RoboSAX/eagle_spielfeld/README.md

# eagle_spielfeld
Masterplatine des Spielfeldes
