RoboSAX/eagle_spielfeld/export/images/circuit.png

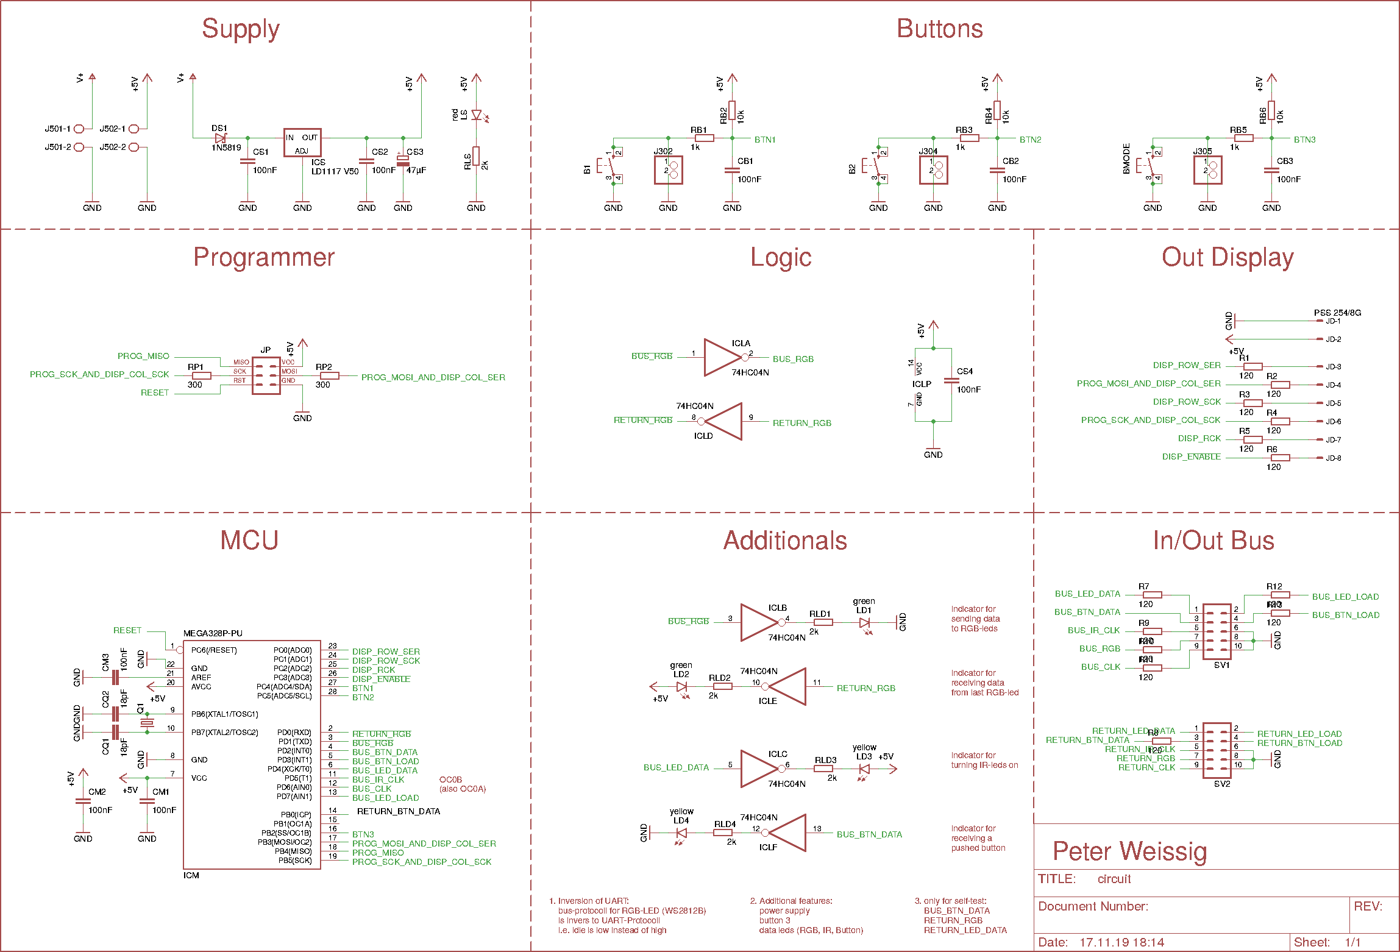
export/images/circuit.png
