RoboSAX/eagle_spielfeld/export/images/layout_bottom.png

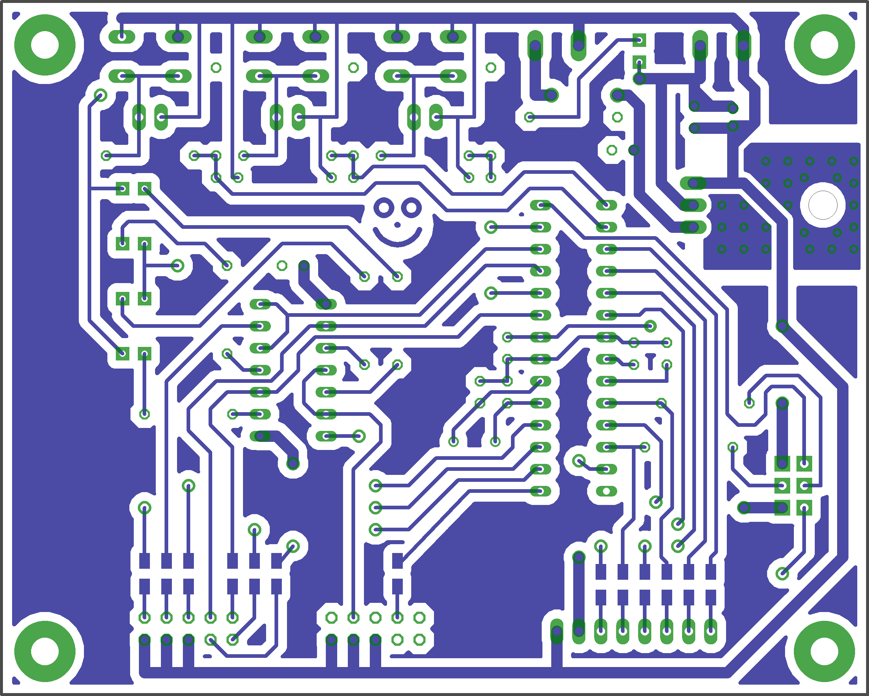
export/images/layout_bottom.png
