RoboSAX/eagle_spielfeld/export/images/layout_top.png

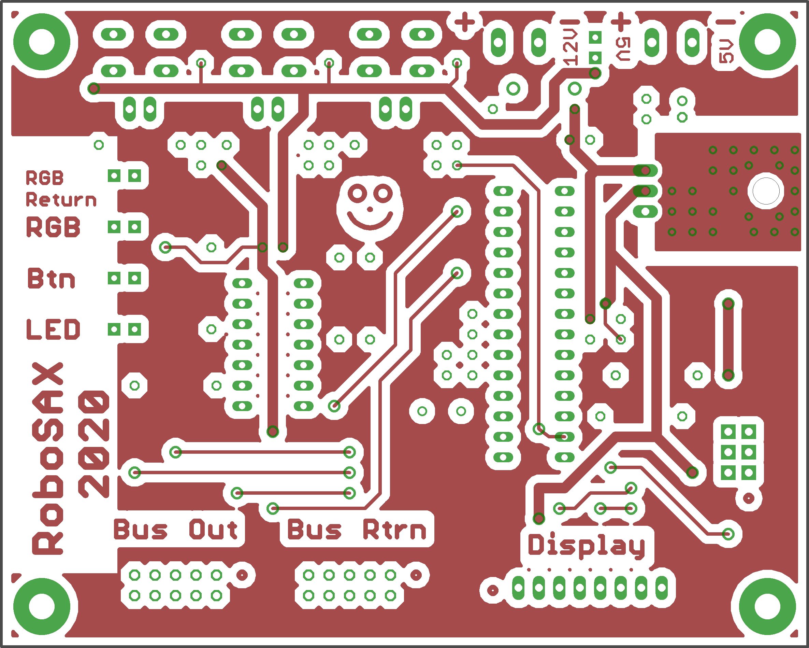
export/images/layout_top.png
