RoboSAX/eagle_spielfeld/parts/parts.pdf

## RoboSAX_spielfeld_tht

das RoboSAX OrgaTeam (PW, MG) | Seite 1 von 2 | 17.11.2019
Name | Value / Description | Order code | # | Prize | Sum
B1, B2, BMODE | button; 6x6mm; h=5mm | 3 | 0,14 € | 0,42 €
CQ1, CQ2 | 18pF; 2,5mm | 2 | 0,05 € | 0,10 €
100nF; 2,5mm | 9 | 0,07 € | 0,63 €
CS3 | 47µF; 2mm; d=5mm | 1 | 0,03 € | 0,03 €
DS1 | low drop | 1 | 0,06 € | 0,06 €
ICL | 6x logic inverter | 1 | 0,35 € | 0,35 €
ICM | atmega 328P | 1 | 2,25 € | 2,25 €
ICS | low-drop; 5V; 1A | 1 | 0,51 € | 0,51 €
J302, J304, J305 | special pin head; 1x2 pins | 3 | 0,05 € | 0,15 €
JD | special pin head; 1x8 pins | 1 | 0,08 € | 0,08 €
JP | box header; 2x3 pins | 1 | 0,20 € | 0,20 €
SV1, SV2 | box header; 2x5 pins | 2 | 0,10 € | 0,20 €
J501, J502 | connecting teminal; 2x | 2 | 0,32 € | 0,64 €
LD1, LD2 | 3mm; 2mA; green | 2 | 0,12 € | 0,24 €
LD3, LD4 | 3mm; 2mA, yellow | 2 | 0,12 € | 0,24 €
LS | 3mm; 2mA, red | 1 | 0,12 € | 0,12 €
Q1 | crystal; 20 MHz | 1 | 0,22 € | 0,22 €
R1, R2, R3, … R13 | 120 | 13 | 0,02 € | 0,26 €
RP1, RP2 | 300 | 2 | 0,08 € | 0,16 €
RB1, RB3, RB5 | 1k | 3 | 0,08 € | 0,24 €
RLD1, RLD2, RLD3, RLD4, RLS | 2k | 5 | 0,08 € | 0,40 €
RB2, RB4, RB6 | 10k | 3 | 0,08 € | 0,24 €

7,74 €

TASTER 9302 (https://www.reichelt.de/kurzhubtaster-6x6mm-hoehe-5-0mm-12v-vertikal-taster-9302-p44579.html)
KERKO 18P (https://www.reichelt.de/keramik-kondensator-18p-kerko-18p-p9274.html)
CB1, CB2, CB3,
CM1, CM2, CM3,
CS1, CS2, CS4

X7R-2,5 100N (https://www.reichelt.de/vielschicht-keramikkondensator-100n-10-x7r-2-5-100n-p22853.html)

RAD 105 47/35 (https://www.reichelt.de/elko-radial-47-f-35-v-rm-2-5-1000h-105-c-20-rad-105-47-35-p42399.html)
1N 5819 (https://www.reichelt.de/schottkydiode-40-v-1-a-do-41-1n-5819-p41850.html)
74HC 04 (https://www.reichelt.de/inverter-hex-2-6-v-dil-14-74hc-04-p3123.html)
ATMEGA 328P-PU (https://www.reichelt.de/mcu-atmega-avr-risc-32-kb-20-mhz-pdip-28-atmega-328p-pu-p119685.html)
LD1117 V50 (https://www.reichelt.de/ldo-regler-fest-5-v-to-220-ld1117-v50-p200893.html)
PSS 254/2G (https://www.reichelt.de/printstecker-einzelstecker-gerade-2-polig-pss-254-2g-p14907.html)
PSS 254/8G (https://www.reichelt.de/printstecker-einzelstecker-gerade-8-polig-pss-254-8g-p14913.html)
WSL 6G (https://www.reichelt.de/wannenstecker-6-polig-gerade-wsl-6g-p85732.html)
WSL 10G (https://www.reichelt.de/wannenstecker-10-polig-gerade-wsl-10g-p22816.html)
AKL 101-02 (https://www.reichelt.de/anschlussklemme-2-pol-2-mm-rm-5-08-akl-101-02-p36605.html)
LED 3MM 2MA GN (https://www.reichelt.de/led-3-mm-bedrahtet-gruen-3-2-mcd-60-led-3mm-2ma-gn-p21624.html)
LED 3MM 2MA GE (https://www.reichelt.de/led-3-mm-bedrahtet-gelb-3-2-mcd-60-led-3mm-2ma-ge-p21628.html)
LED 3MM 2MA RT (https://www.reichelt.de/led-3-mm-bedrahtet-rot-5-mcd-60-led-3mm-2ma-rt-p21626.html)
20,0000-HC49U-S (https://www.reichelt.de/standardquarz-grundton-20-000000-mhz-20-0000-hc49u-s-p32853.html)
RND 1206 1 120 (https://www.reichelt.de/smd-widerstand-1206-120-ohm-250-mw-1-rnd-1206-1-120-p183350.html)
METALL 300 (https://www.reichelt.de/widerstand-metallschicht-300-ohm-0207-0-6-w-1-metall-300-p11715.html)
METALL 1,00K (https://www.reichelt.de/widerstand-metallschicht-1-00-kohm-0207-0-6-w-1-metall-1-00k-p11403.html)
METALL 2,00K (https://www.reichelt.de/widerstand-metallschicht-2-00-kohm-0207-0-6-w-1-metall-2-00k-p11578.html)
METALL 10,0K (https://www.reichelt.de/widerstand-metallschicht-10-0-kohm-0207-0-6-w-1-metall-10-0k-p11449.html)
Shopping cart (also some additional parts): | https://www.reichelt.de/my/1638795

## Additionals

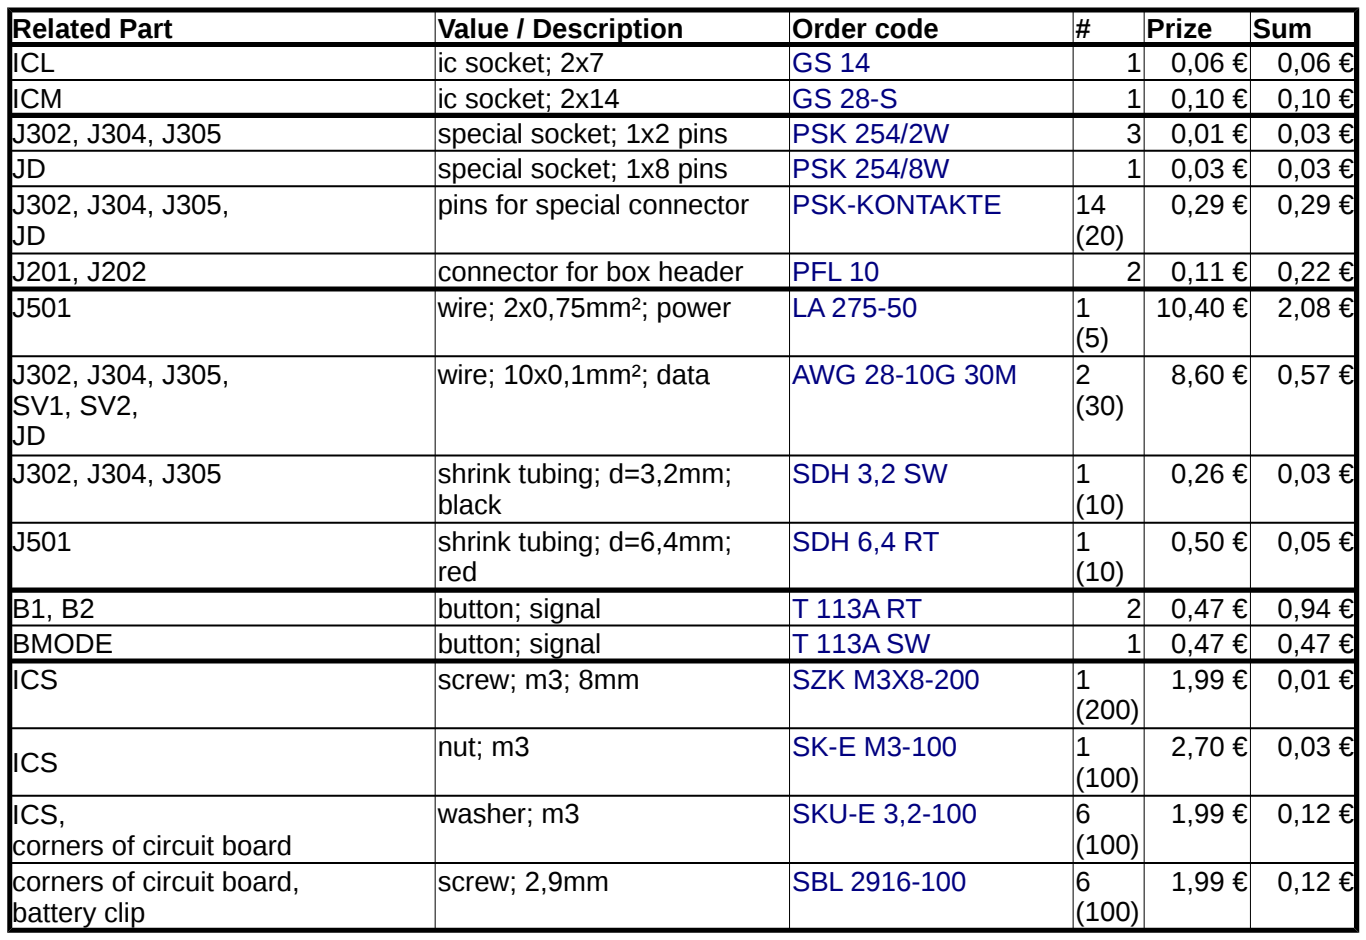
[picture p4: figure]
Related Part; Value / Description; Order code; Prize; Sum; ICL; ic socket; 2x7; ICM; ic socket; 2x14; special socket; 1x2 pins; special socket; 1x8 pins; pins for special connector; connector for box header; wire; 2x0,75mm²; power; wire; 10x0,1mm²; data; button; signal; BMODE; ICS; screw; m3; 8mm; nut; m3; washer; m3; screw; 2,9mm; GS 14 GS 28-S PSK 254/2W PSK 254/8W; PSK-KONTAKTE; PFL 10; AWG 28-10G 30M; shrink tubing; d=3,2mm; black; SDH 3,2 SW; shrink tubing; d=6,4mm; red; SDH 6,4 RT; SZK M3X8-200; ICS, corners of circuit board; SKU-E 3,2-100; corners of circuit board, battery clip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

das RoboSAX OrgaTeam (PW, MG) | Seite 2 von 2 | 17.11.2019

5,15 €

Shopping cart (some additional and all main parts): https://www.reichelt.de/my/1638795
