RoboSAX/eagle_spielfeld/parts/parts.ods

Sheet: RoboSAX_spielfeld_tht
Name | Value / Description | Order code | # | Prize | Sum
B1, B2, BMODE | button; 6x6mm; h=5mm | TASTER 9302 (https://www.reichelt.de/kurzhubtaster-6x6mm-hoehe-5-0mm-12v-vertikal-taster-9302-p44579.html) | 3 | 0,14 € | 0,42 €
CQ1, CQ2 | 18pF; 2,5mm | KERKO 18P (https://www.reichelt.de/keramik-kondensator-18p-kerko-18p-p9274.html) | 2 | 0,05 € | 0,10 €
CB1, CB2, CB3, CM1, CM2, CM3, CS1, CS2, CS4 | 100nF; 2,5mm | X7R-2,5 100N (https://www.reichelt.de/vielschicht-keramikkondensator-100n-10-x7r-2-5-100n-p22853.html) | 9 | 0,07 € | 0,63 €
CS3 | 47µF; 2mm; d=5mm | RAD 105 47/35 (https://www.reichelt.de/elko-radial-47-f-35-v-rm-2-5-1000h-105-c-20-rad-105-47-35-p42399.html) | 1 | 0,03 € | 0,03 €
DS1 | low drop | 1N 5819 (https://www.reichelt.de/schottkydiode-40-v-1-a-do-41-1n-5819-p41850.html) | 1 | 0,06 € | 0,06 €
ICL | 6x logic inverter | 74HC 04 (https://www.reichelt.de/inverter-hex-2-6-v-dil-14-74hc-04-p3123.html) | 1 | 0,35 € | 0,35 €
ICM | atmega 328P | ATMEGA 328P-PU (https://www.reichelt.de/mcu-atmega-avr-risc-32-kb-20-mhz-pdip-28-atmega-328p-pu-p119685.html) | 1 | 2,25 € | 2,25 €
ICS | low-drop; 5V; 1A | LD1117 V50 (https://www.reichelt.de/ldo-regler-fest-5-v-to-220-ld1117-v50-p200893.html) | 1 | 0,51 € | 0,51 €
J302, J304, J305 | special pin head; 1x2 pins | PSS 254/2G (https://www.reichelt.de/printstecker-einzelstecker-gerade-2-polig-pss-254-2g-p14907.html) | 3 | 0,05 € | 0,15 €
JD | special pin head; 1x8 pins | PSS 254/8G (https://www.reichelt.de/printstecker-einzelstecker-gerade-8-polig-pss-254-8g-p14913.html) | 1 | 0,08 € | 0,08 €
JP | box header; 2x3 pins | WSL 6G (https://www.reichelt.de/wannenstecker-6-polig-gerade-wsl-6g-p85732.html) | 1 | 0,20 € | 0,20 €
SV1, SV2 | box header; 2x5 pins | WSL 10G (https://www.reichelt.de/wannenstecker-10-polig-gerade-wsl-10g-p22816.html) | 2 | 0,10 € | 0,20 €
J501, J502 | connecting teminal; 2x | AKL 101-02 (https://www.reichelt.de/anschlussklemme-2-pol-2-mm-rm-5-08-akl-101-02-p36605.html) | 2 | 0,32 € | 0,64 €
LD1, LD2 | 3mm; 2mA; green | LED 3MM 2MA GN (https://www.reichelt.de/led-3-mm-bedrahtet-gruen-3-2-mcd-60-led-3mm-2ma-gn-p21624.html) | 2 | 0,12 € | 0,24 €
LD3, LD4 | 3mm; 2mA, yellow | LED 3MM 2MA GE (https://www.reichelt.de/led-3-mm-bedrahtet-gelb-3-2-mcd-60-led-3mm-2ma-ge-p21628.html) | 2 | 0,12 € | 0,24 €
LS | 3mm; 2mA, red | LED 3MM 2MA RT (https://www.reichelt.de/led-3-mm-bedrahtet-rot-5-mcd-60-led-3mm-2ma-rt-p21626.html) | 1 | 0,12 € | 0,12 €
Q1 | crystal; 20 MHz | 20,0000-HC49U-S (https://www.reichelt.de/standardquarz-grundton-20-000000-mhz-20-0000-hc49u-s-p32853.html) | 1 | 0,22 € | 0,22 €
R1, R2, R3, … R13 | 120 | RND 1206 1 120 (https://www.reichelt.de/smd-widerstand-1206-120-ohm-250-mw-1-rnd-1206-1-120-p183350.html) | 13 | 0,02 € | 0,26 €
RP1, RP2 | 300 | METALL 300 (https://www.reichelt.de/widerstand-metallschicht-300-ohm-0207-0-6-w-1-metall-300-p11715.html) | 2 | 0,08 € | 0,16 €
RB1, RB3, RB5 | 1k | METALL 1,00K (https://www.reichelt.de/widerstand-metallschicht-1-00-kohm-0207-0-6-w-1-metall-1-00k-p11403.html) | 3 | 0,08 € | 0,24 €
RLD1, RLD2, RLD3, RLD4, RLS | 2k | METALL 2,00K (https://www.reichelt.de/widerstand-metallschicht-2-00-kohm-0207-0-6-w-1-metall-2-00k-p11578.html) | 5 | 0,08 € | 0,40 €
RB2, RB4, RB6 | 10k | METALL 10,0K (https://www.reichelt.de/widerstand-metallschicht-10-0-kohm-0207-0-6-w-1-metall-10-0k-p11449.html) | 3 | 0,08 € | 0,24 €
 |  |  | 7,74 €
Shopping cart (also some additional parts): |  |  | https://www.reichelt.de/my/1638795

Sheet: Additionals
Related Part | Value / Description | Order code | # | Prize | Sum
ICL | ic socket; 2x7 | GS 14 (https://www.reichelt.de/ic-sockel-14-polig-doppelter-federkontakt-gs-14-p8206.html) | 1 | 0,06 € | 0,06 €
ICM | ic socket; 2x14 | GS 28-S (https://www.reichelt.de/ic-sockel-28-polig-doppelter-federkontakt-gs-28-s-p86281.html) | 1 | 0,10 € | 0,10 €
J302, J304, J305 | special socket; 1x2 pins | PSK 254/2W (https://www.reichelt.de/kupplungs-leergehaeuse-crimptechnik-2-polig-psk-254-2w-p14857.html) | 3 | 0,01 € | 0,03 €
JD | special socket; 1x8 pins | PSK 254/8W (https://www.reichelt.de/kupplungs-leergehaeuse-crimptechnik-8-polig-psk-254-8w-p14860.html) | 1 | 0,03 € | 0,03 €
J302, J304, J305, JD | pins for special connector | PSK-KONTAKTE (https://www.reichelt.de/crimpkontakte-fuer-psk-254-20-stueck-psk-kontakte-p14861.html) | 14 (20) | 0,29 € | 0,29 €
J201, J202 | connector for box header | PFL 10 (https://www.reichelt.de/pfostenbuchse-10-polig-mit-zugentlastung-pfl-10-p14571.html) | 2 | 0,11 € | 0,22 €
J501 | wire; 2x0,75mm²; power | LA 275-50 (https://www.reichelt.de/zwillingslitze-flexibel-2x0-75mm-50m-ring-la-275-50-p36246.html) | 1 (5) | 10,40 € | 2,08 €
J302, J304, J305, SV1, SV2, JD | wire; 10x0,1mm²; data | AWG 28-10G 30M (https://www.reichelt.de/flachbandkabel-awg28-10-pol-grau-30m-rolle-awg-28-10g-30m-p47622.html) | 2 (30) | 8,60 € | 0,57 €
J302, J304, J305 | shrink tubing; d=3,2mm; black | SDH 3,2 SW (https://www.reichelt.de/10er-pack-2-1-schrumpfschlauch-3-2mm-schwarz-sdh-3-2-sw-p17406.html) | 1 (10) | 0,26 € | 0,03 €
J501 | shrink tubing; d=6,4mm; red | SDH 6,4 RT (https://www.reichelt.de/10er-pack-2-1-schrumpfschlauch-6-4mm-rot-sdh-6-4-rt-p17413.html) | 1 (10) | 0,50 € | 0,05 €
B1, B2 | button; signal | T 113A RT (https://www.reichelt.de/miniatur-drucktaster-0-5a-24vac-1x-ein-rt-t-113a-rt-p45166.html) | 2 | 0,47 € | 0,94 €
BMODE | button; signal | T 113A SW (https://www.reichelt.de/miniatur-drucktaster-0-5a-24vac-1x-ein-sw-t-113a-sw-p45167.html) | 1 | 0,47 € | 0,47 €
ICS | screw; m3; 8mm | SZK M3X8-200 (https://www.reichelt.de/zylinderkopfschrauben-schlitz-m3-8-mm-szk-m3x8-200-p65693.html) | 1 (200) | 1,99 € | 0,01 €
ICS | nut; m3 | SK-E M3-100 (https://www.reichelt.de/sechskantmuttern-edelstahl-a2-m3-sk-e-m3-100-p72592.html) | 1 (100) | 2,70 € | 0,03 €
ICS, corners of circuit board | washer; m3 | SKU-E 3,2-100 (https://www.reichelt.de/unterlegscheiben-edelstahl-a2-3-2-mm-sku-e-3-2-100-p72588.html) | 6 (100) | 1,99 € | 0,12 €
corners of circuit board, battery clip | screw; 2,9mm | SBL 2916-100 (https://www.reichelt.de/blechschrauben-pan-head-pzd-2-9-x-16-mm-sbl-2916-100-p130327.html) | 6 (100) | 1,99 € | 0,12 €
 |  |  | 5,15 €
Shopping cart (some additional and all main parts): |  |  | https://www.reichelt.de/my/1638795
