RoboSAX/eagle_spielfeld/export/images/parts_bottom.png

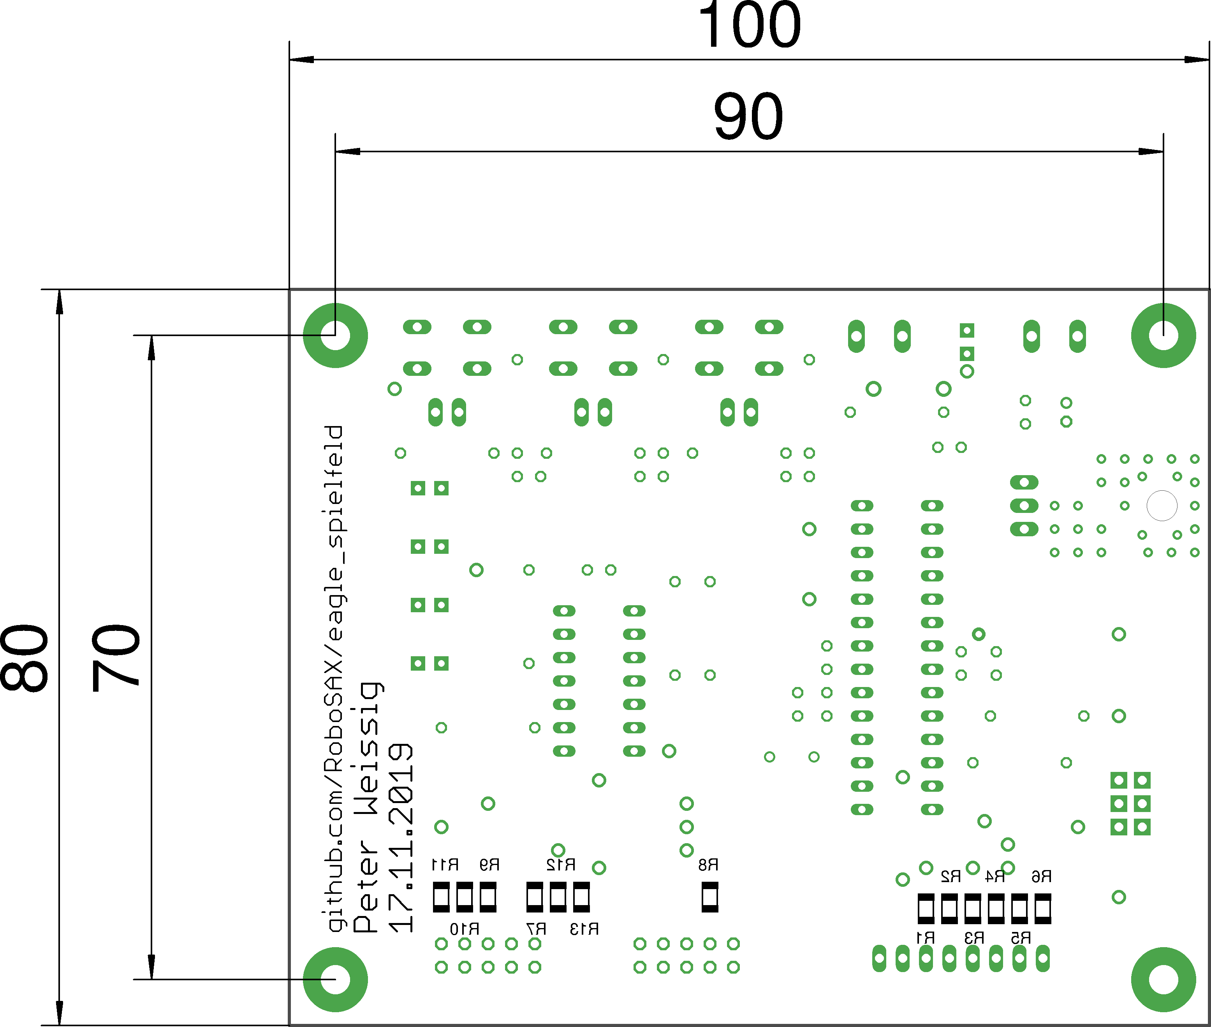
export/images/parts_bottom.png
