RoboSAX/eagle_spielfeld/export/images/parts_top.png

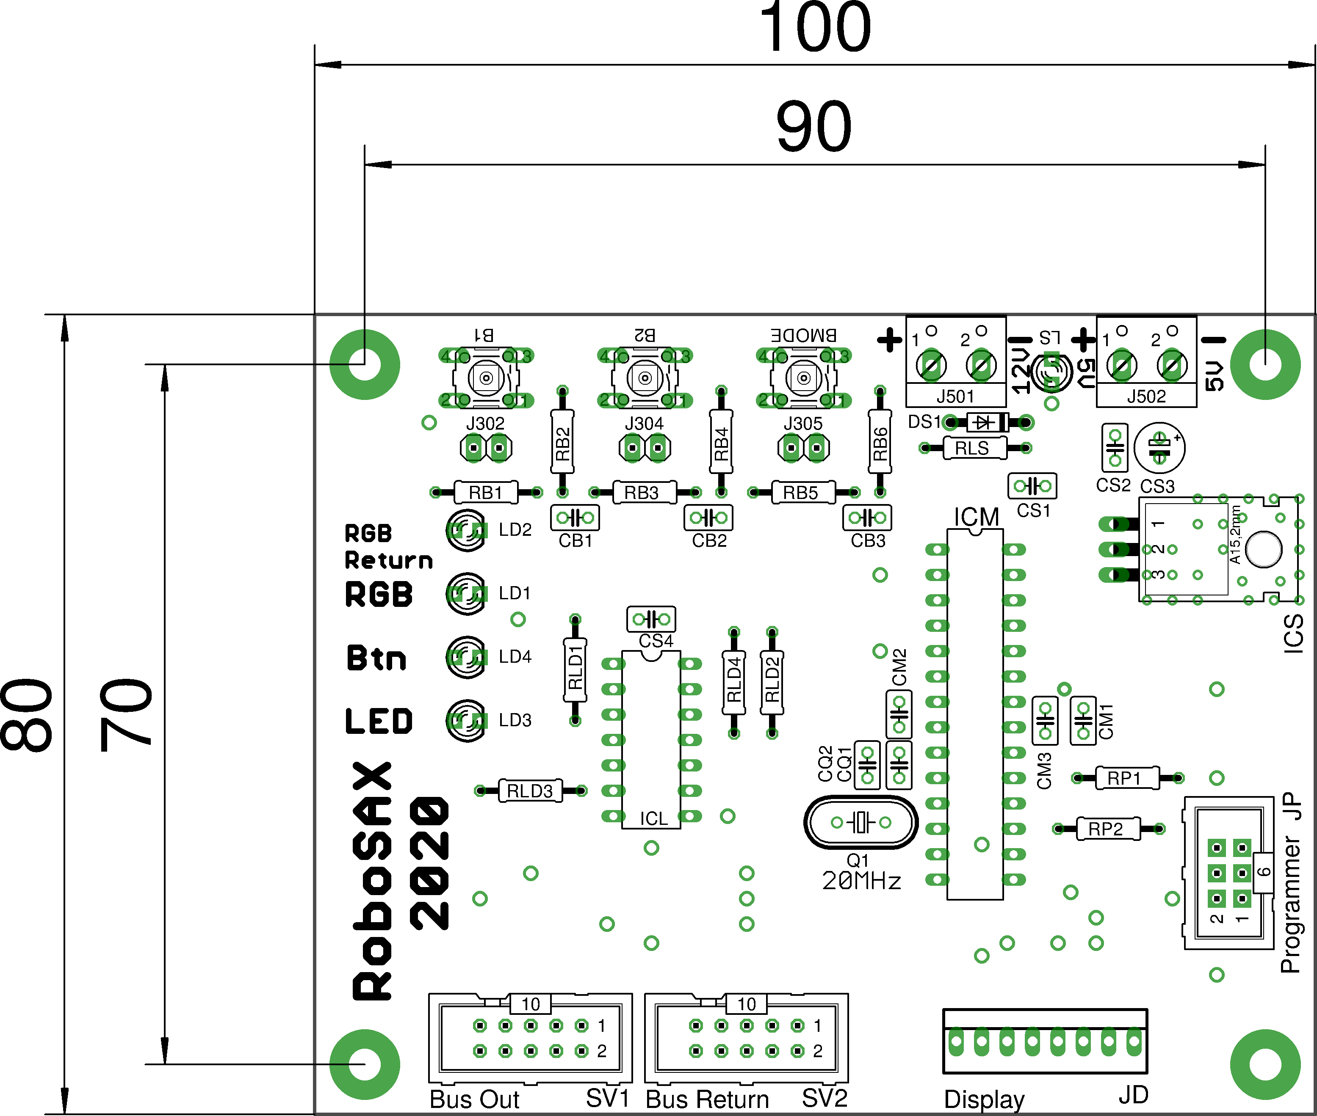
export/images/parts_top.png
