RoboSAX/eagle_spielfeld/export/images/circuit.pdf

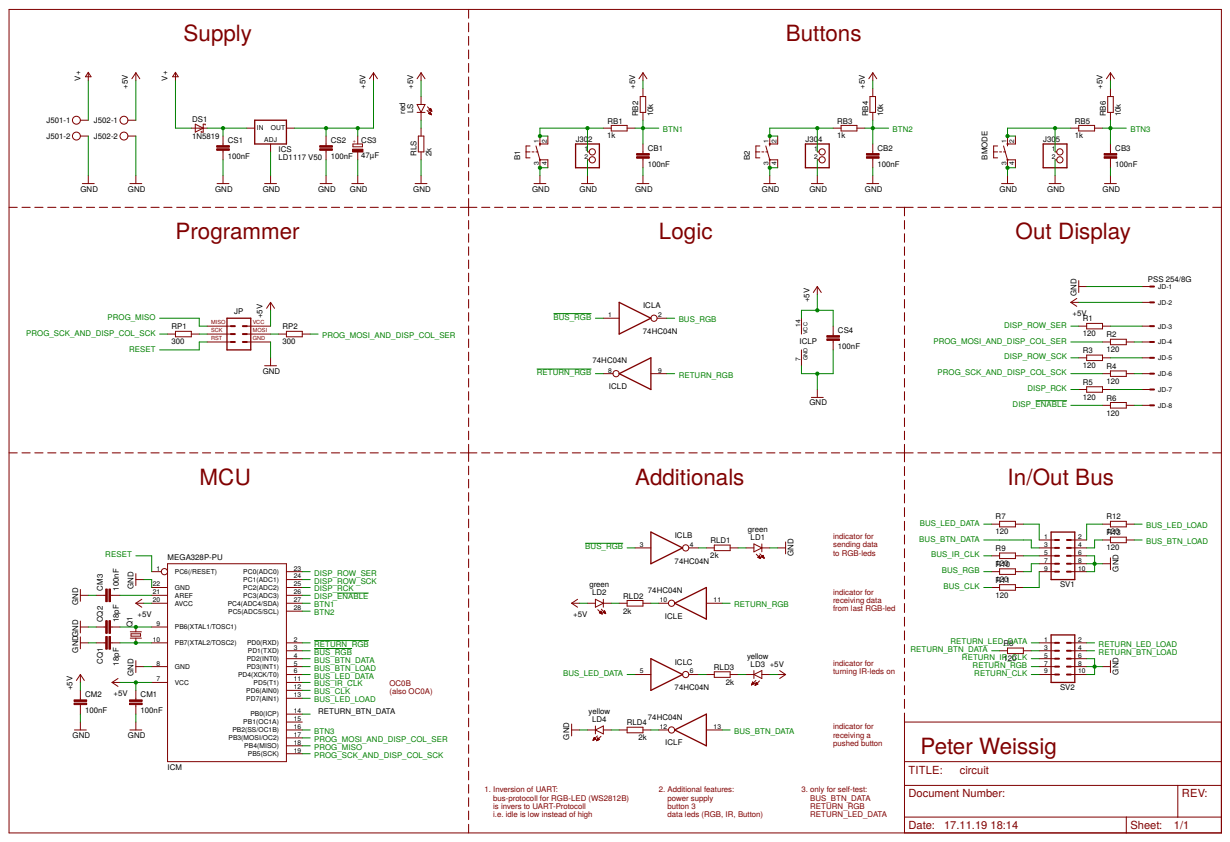
[picture p7: page 1]

indicator for sending data
to RGB-leds

indicator for
receiving data
from last RGB-led

turning IR-leds on

REV: TITLE: Document Number: circuit

1. Inversion of UART: bus-protocoll for RGB-LED (WS2812B)
is invers to UART-Protocoll
i.e. idle is low instead of high

2. Additional features: power supply button 3

3. only for self-test: BUS_BTN_DATA RETURN_RGB RETURN_LED_DATA

data leds (RGB, IR, Button)
