RoboSAX/eagle_spielfeld/circuit/circuit.brd

## EAGLE design circuit/circuit.brd (2019-11-17)

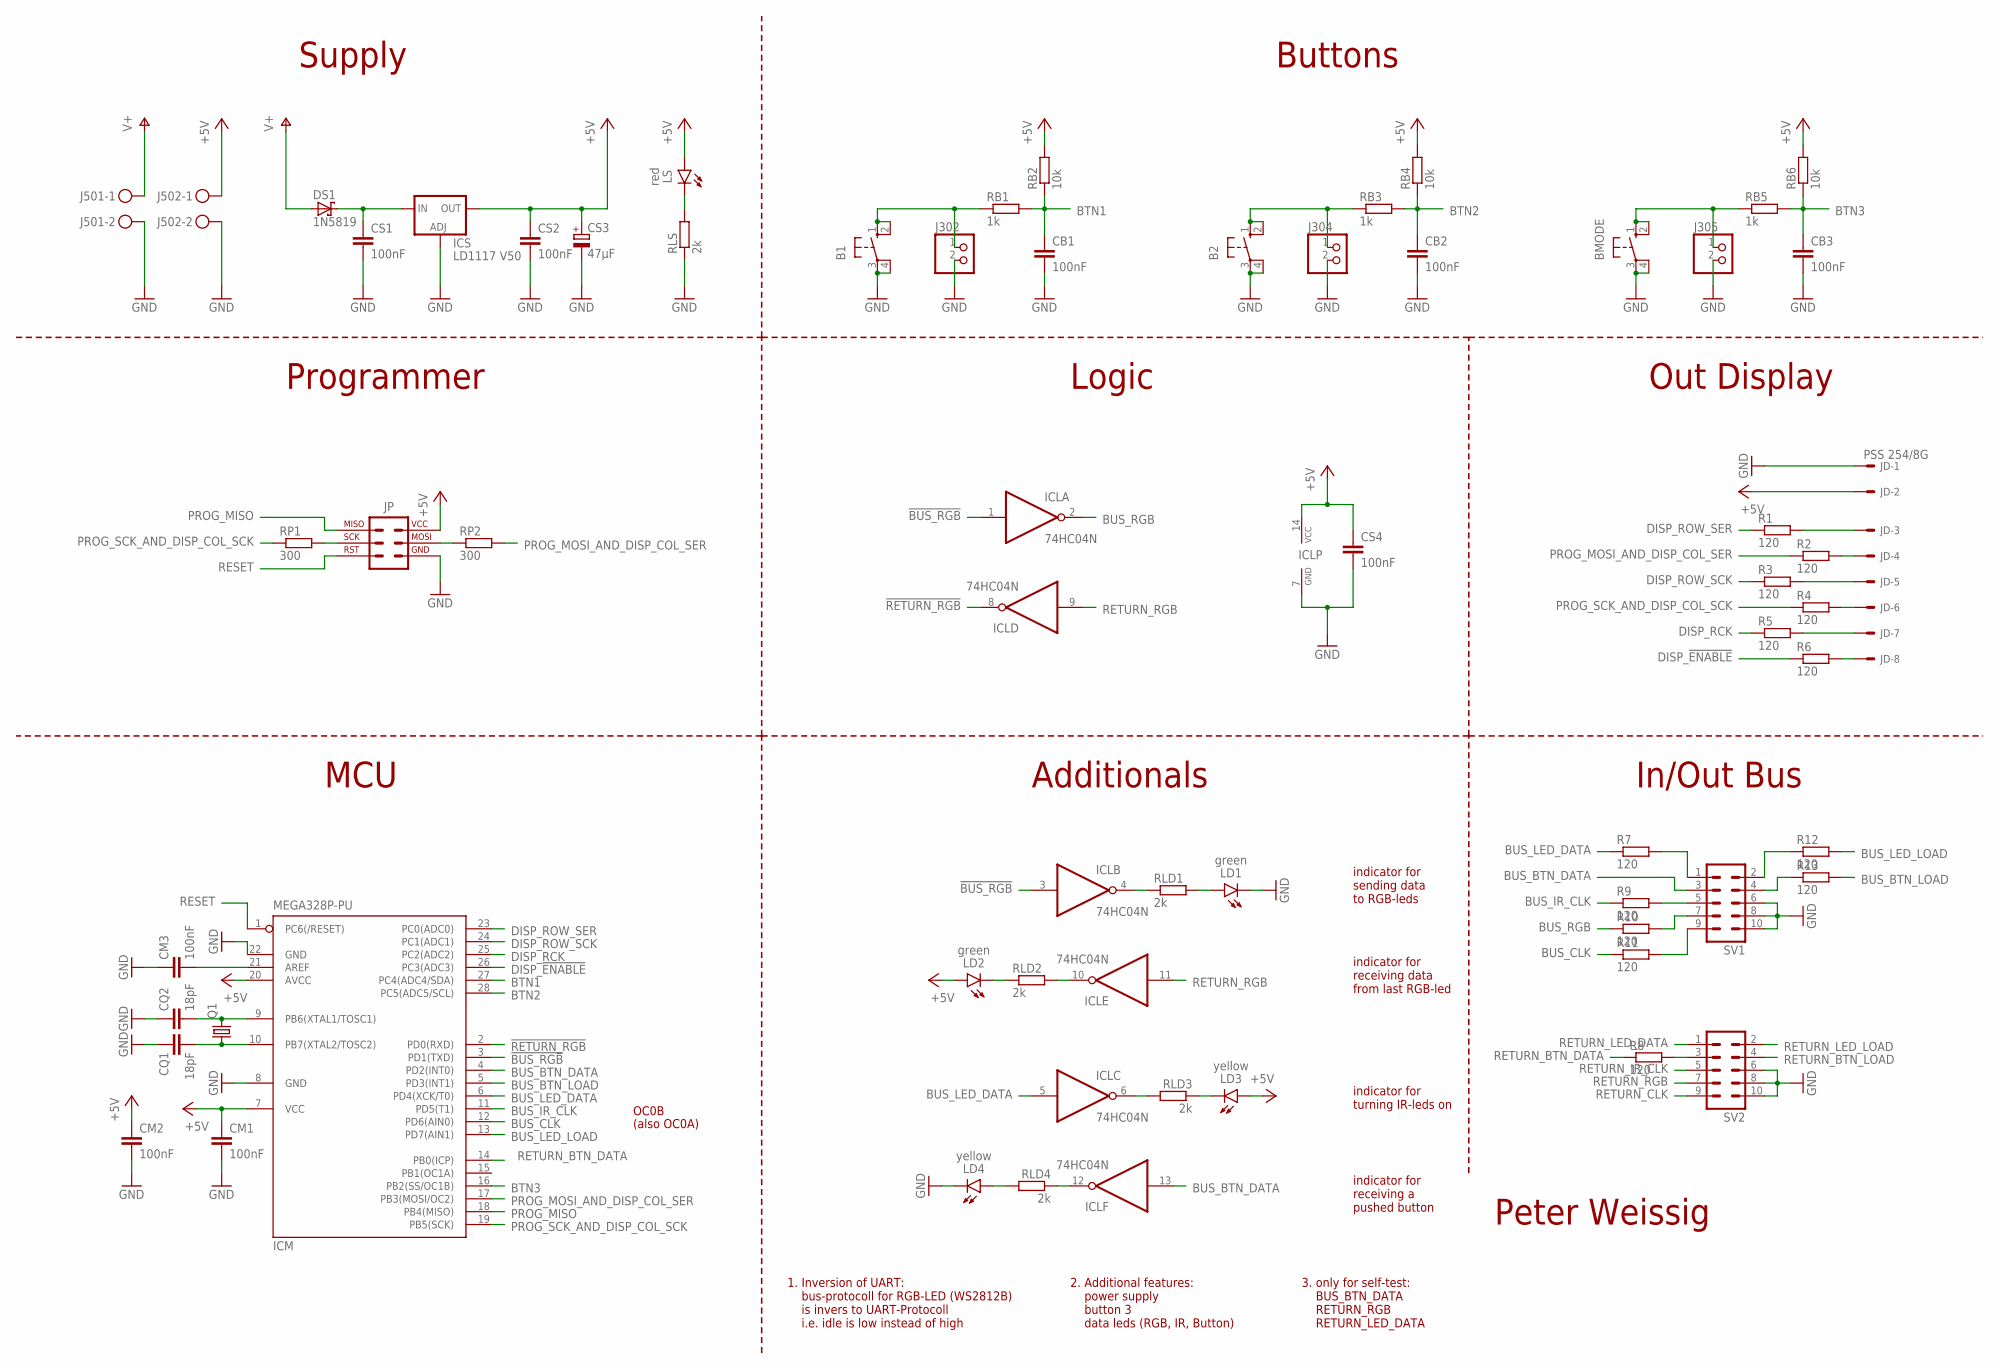
[picture p8: schematic circuit.sch]

Parts:
B1, B2: 10-XX; B3F-10XX
BMODE: 10-XX; B3F-10XX
CB1, CB2, CB3: 100nF; C025-025X050
CM1, CM2, CM3: 100nF; C025-025X050
CQ1, CQ2: 18pF; C025-025X050
CS1, CS2, CS4: 100nF; C025-025X050
CS3: 47µF; E2-5
DS1: 1N5819; DO41-7.6
ICL: 74HC04N; DIL14
ICM: MEGA328P-PU; DIL28-3
ICS: LD1117 V50; TO220L1
J302, J304, J305: PINHD-1X2; 1X02
J501, J502: STECKER_SPG_2
JD: PSS 254/8G; 22-23-2081
JP: STECKER_ISP_6; STECKER_WANNE_6
LD1, LD2: green; LED_3MM
LD3, LD4: yellow; LED_3MM
LS: red; LED_3MM
Q1: CRYSTALHC49U70; HC49U70
R1, R2, R3, R4, R5, R6, R7, R8, R9, R10, R11, R12, R13: 120; R1206W
RB1, RB3, RB5: 1k; 0207/10
RB2, RB4, RB6: 10k; 0207/10
RLD1, RLD2, RLD3, RLD4: 2k; 0207/10
RLS: 2k; 0207/10
RP1, RP2: 300; 0207/10
SV1, SV2: ML10

Connections:
!BUS_RGB: ICL.1 (I), ICL.3 (I), ICM.3 (PD1(TXD))
!RETURN_RGB: ICL.8 (O), ICM.2 (PD0(RXD))
+5V: CM1.1, CM2.1, CS2.1, CS3.+, CS4.1, ICL.14 (VCC), ICM.7 (VCC), ICM.20 (AVCC), ICS.2 (OUT), J502.1, JD.2, JP.2 (2_VCC), LD2.A, LD3.A, LS.A, RB2.2, RB4.2, RB6.2
BTN1: CB1.1, ICM.27 (PC4(ADC4/SDA)), RB1.2, RB2.1
BTN2: CB2.1, ICM.28 (PC5(ADC5/SCL)), RB3.2, RB4.1
BTN3: CB3.1, ICM.16 (PB2(SS/OC1B)), RB5.2, RB6.1
BUS_BTN_DATA: ICL.13 (I), ICM.4 (PD2(INT0)), SV1.3
BUS_BTN_LOAD: ICM.5 (PD3(INT1)), R13.2
BUS_CLK: ICM.12 (PD6(AIN0)), R11.1
BUS_IR_CLK: ICM.11 (PD5(T1)), R9.1
BUS_LED_DATA: ICL.5 (I), ICM.6 (PD4(XCK/T0)), R7.1
BUS_LED_LOAD: ICM.13 (PD7(AIN1)), R12.2
BUS_RGB: ICL.2 (O), R10.1
DISP_!ENABLE!: ICM.26 (PC3(ADC3)), R6.1
DISP_RCK: ICM.25 (PC2(ADC2)), R5.1
DISP_ROW_SCK: ICM.24 (PC1(ADC1)), R3.1
DISP_ROW_SER: ICM.23 (PC0(ADC0)), R1.1
GND: B1.3, B1.4 (P1), B2.3, B2.4 (P1), BMODE.3, BMODE.4 (P1), CB1.2, CB2.2, CB3.2, CM1.2, CM2.2, CM3.1, CQ1.1, CQ2.1, CS1.2, CS2.2, CS3.-, CS4.2, ICL.7 (GND), ICM.8 (GND), ICM.22 (GND), ICS.1 (ADJ), J302.2, J304.2, J305.2, J501.2, J502.2, JD.1, JP.6 (6_GND), LD1.K (C), LD4.K (C), RLS.1, SV1.6, SV1.8, SV1.10, SV2.6, SV2.8, SV2.10
unnamed: R7.2, SV1.1
unnamed: R8.2, SV2.3
unnamed: R9.2, SV1.5
unnamed: B1.1 (S), B1.2 (S1), J302.1, RB1.1
unnamed: CS1.1, DS1.C, ICS.3 (IN)
unnamed: B2.1 (S), B2.2 (S1), J304.1, RB3.1
unnamed: BMODE.1 (S), BMODE.2 (S1), J305.1, RB5.1
unnamed: CQ1.2, ICM.10 (PB7(XTAL2/TOSC2)), Q1.1
unnamed: CQ2.2, ICM.9 (PB6(XTAL1/TOSC1)), Q1.2
unnamed: LS.K (C), RLS.2
unnamed: CM3.2, ICM.21 (AREF)
unnamed: R10.2, SV1.7
unnamed: R11.2, SV1.9
unnamed: R13.1, SV1.4
unnamed: R12.1, SV1.2
unnamed: JD.3, R1.2
unnamed: JD.4, R2.2
unnamed: JD.5, R3.2
unnamed: JD.6, R4.2
unnamed: JD.7, R5.2
unnamed: JD.8, R6.2
unnamed: LD1.A, RLD1.2
unnamed: ICL.4 (O), RLD1.1
unnamed: ICL.10 (O), RLD2.2
unnamed: JP.3 (3_SCK), RP1.2
unnamed: LD2.K (C), RLD2.1
unnamed: ICL.6 (O), RLD3.2
unnamed: LD3.K (C), RLD3.1
unnamed: ICL.12 (O), RLD4.1
unnamed: LD4.A, RLD4.2
PROG_MISO: ICM.18 (PB4(MISO)), JP.1 (1_MISO)
PROG_MOSI_1: JP.4 (4_MOSI), RP2.1
PROG_MOSI_AND_DISP_COL_SER: ICM.17 (PB3(MOSI/OC2)), R2.1, RP2.2
PROG_SCK_AND_DISP_COL_SCK: ICM.19 (PB5(SCK)), R4.1, RP1.1
RESET: ICM.1 (PC6(/RESET)), JP.5 (5_RST)
RETURN_BTN_DATA: ICM.14 (PB0(ICP)), R8.1
RETURN_BTN_LOAD: SV2.4
RETURN_CLK: SV2.9
RETURN_IR_CLK: SV2.5
RETURN_LED_DATA: SV2.1
RETURN_LED_LOAD: SV2.2
RETURN_RGB: ICL.9 (I), ICL.11 (I), SV2.7
V+: DS1.A, J501.1

Notes on the sheet:
Peter Weissig
Supply
Buttons
MCU
Programmer
Out Display
In/Out Bus
Logic
1. Inversion of UART: bus-protocoll for RGB-LED (WS2812B) is invers to UART-Protocoll i.e. idle is low instead of high
3. only for self-test: BUS_BTN_DATA RETURN_RGB RETURN_LED_DATA
2. Additional features: power supply button 3 data leds (RGB, IR, Button)
(also OC0A)
OC0B
Additionals
indicator for sending data to RGB-leds
indicator for receiving data from last RGB-led
indicator for turning IR-leds on
indicator for receiving a pushed button

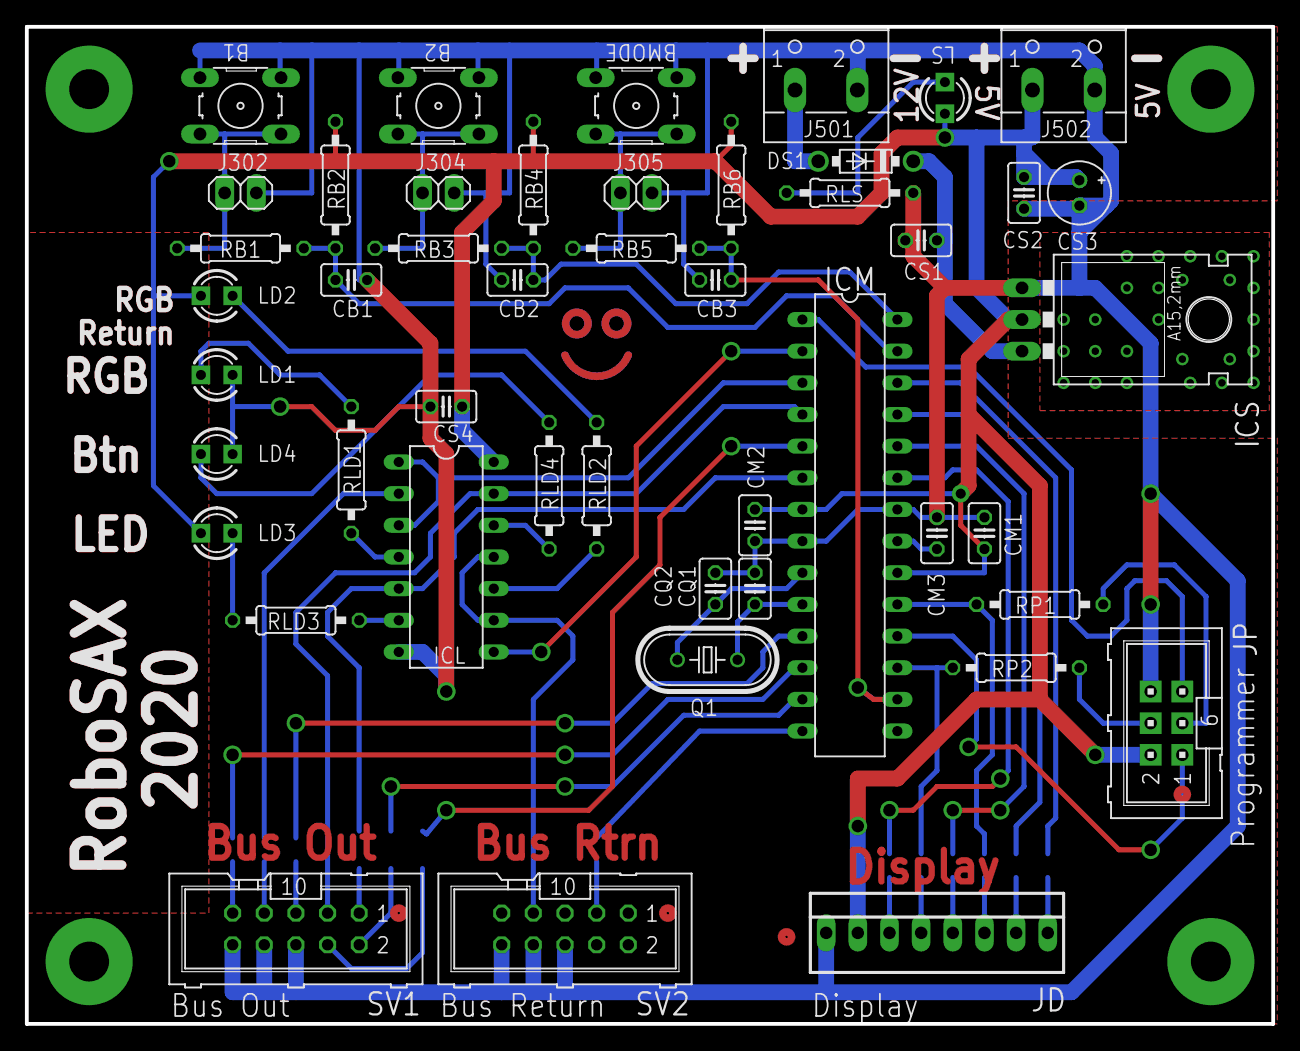
[picture p9: board circuit.brd from above]

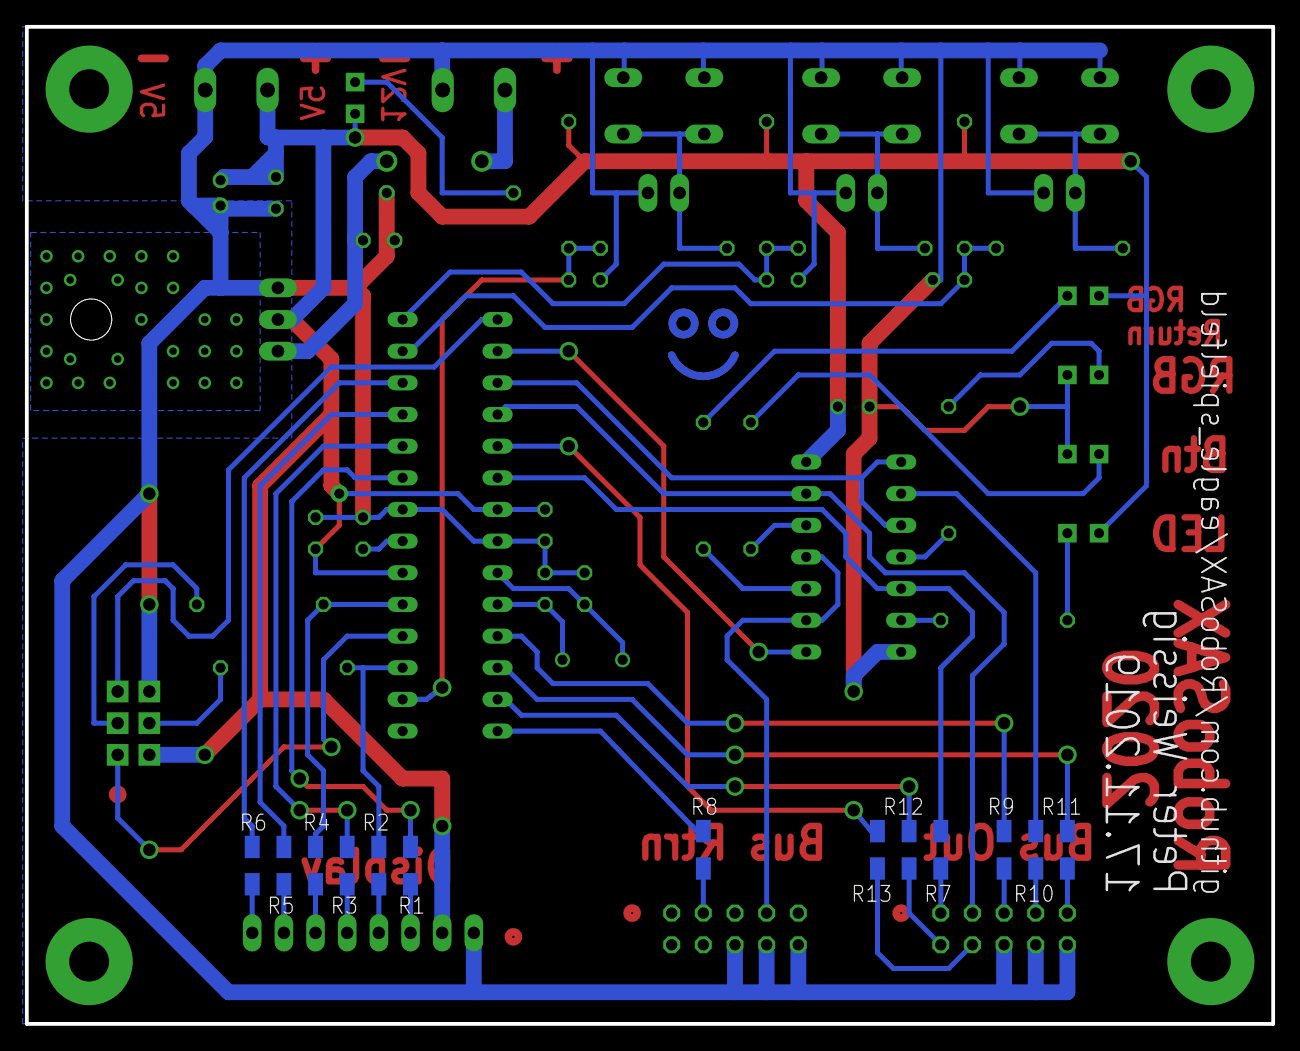
[picture p10: board circuit.brd from below]

Board: 2 copper layers, 100.0 x 80.0 mm, 60 parts (13 on the bottom side), 56 nets.
