RoboSAX/eagle_spielfeld/(commit log)

2018-05-16 initial commit (copy of eagle_licht)
    [circuit.brd, circuit.sch, parts.ods]
2018-05-17 initial changes from elias
    [circuit.brd, circuit.sch, parts.ods]
2018-05-18 updated circuit (layout needs to be done next)
    [circuit.brd, circuit.sch]
2018-05-22 added exported data (circuit and layout are not done yet)
2018-05-23 Updated Layout
    Layout work in progress
    [circuit.brd, circuit.sch]
2018-05-23 minor changes
    [circuit.brd]
2018-05-24 Layout nearly completed
    [circuit.brd, circuit.sch]
2018-05-24 Layout finished
    [circuit.brd]
2019-04-29 updated layout of circuit board + improved readability of labels + added info labels to bottom + added smiley
    [circuit.brd, circuit.sch]
2019-04-29 added export for elecrow
    [circuit.GBL, circuit.GBO, circuit.GBP, circuit.GBS, circuit.GTL, circuit.GTO, circuit.GTP, circuit.GTS]
2019-11-06 updated circuit + changed font type and size (e.g. fixed size of url) + updated cooling pad for voltage regulator + added more spacing at buttons (between pinheads and resistors) + updated part-list
    [circuit.brd, circuit.sch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]
2019-11-11 added Reichelt shopping cart
    [parts.ods]
2019-11-17 minor fixes: + updated crystal from 16 to 20 MHz + updated package for SMD resistors (1206 instead of 0805) + fixed wrong caption (from 2019 to 2020) ==> newly exported images and elecrow files ==> u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
    [circuit.GBL, circuit.GBO, circuit.GBP, circuit.GBS, circuit.GTL, circuit.GTO, circuit.GTP, circuit.GTS]
